ricepanda69/VR-Gloves/Media/IMG_1518.jpg

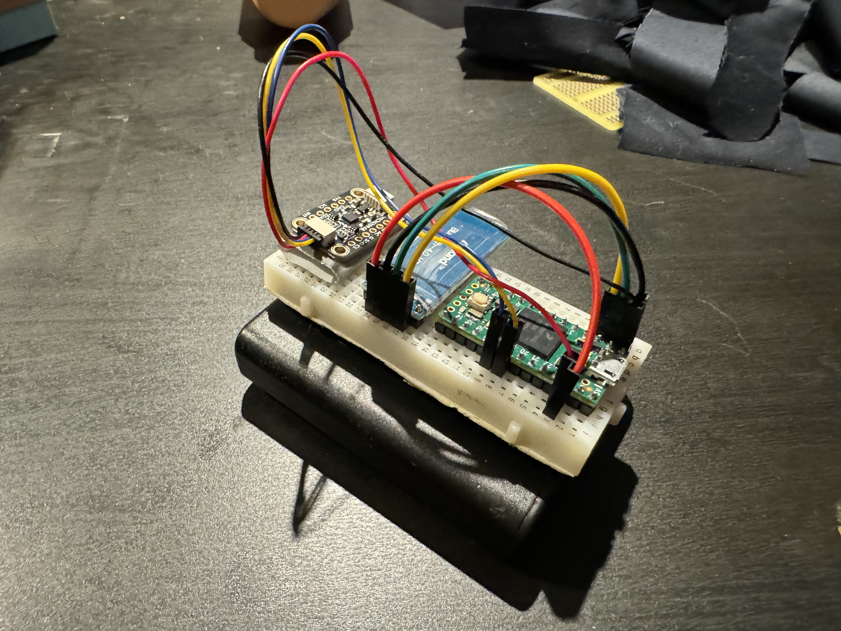
Media/IMG_1518.jpg
