ricepanda69/VR-Gloves/Media/IMG_1519.jpg

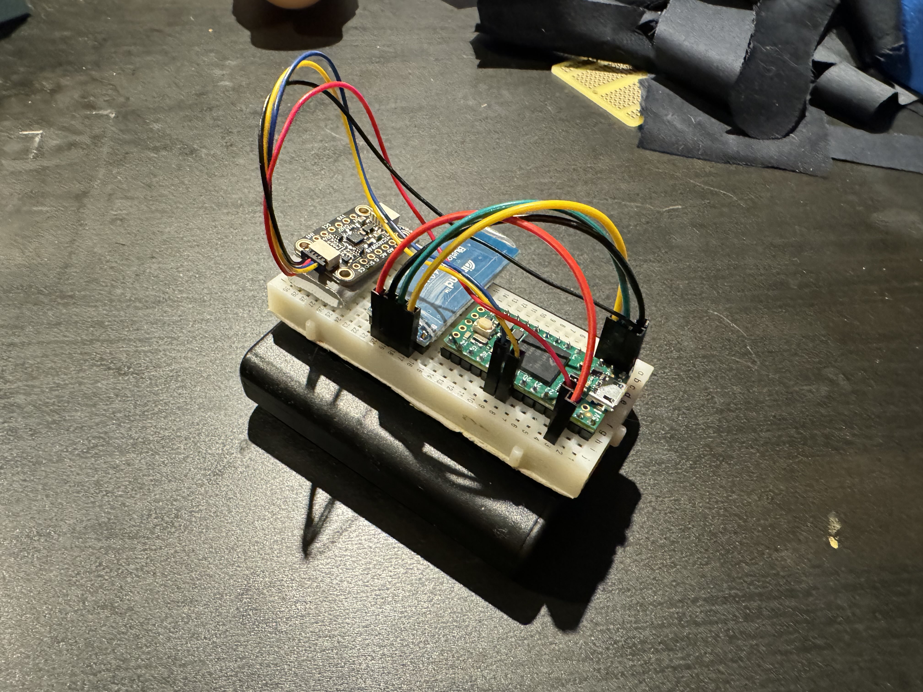
Media/IMG_1519.jpg
