ricepanda69/VR-Gloves/Media/IMG_1520.jpg

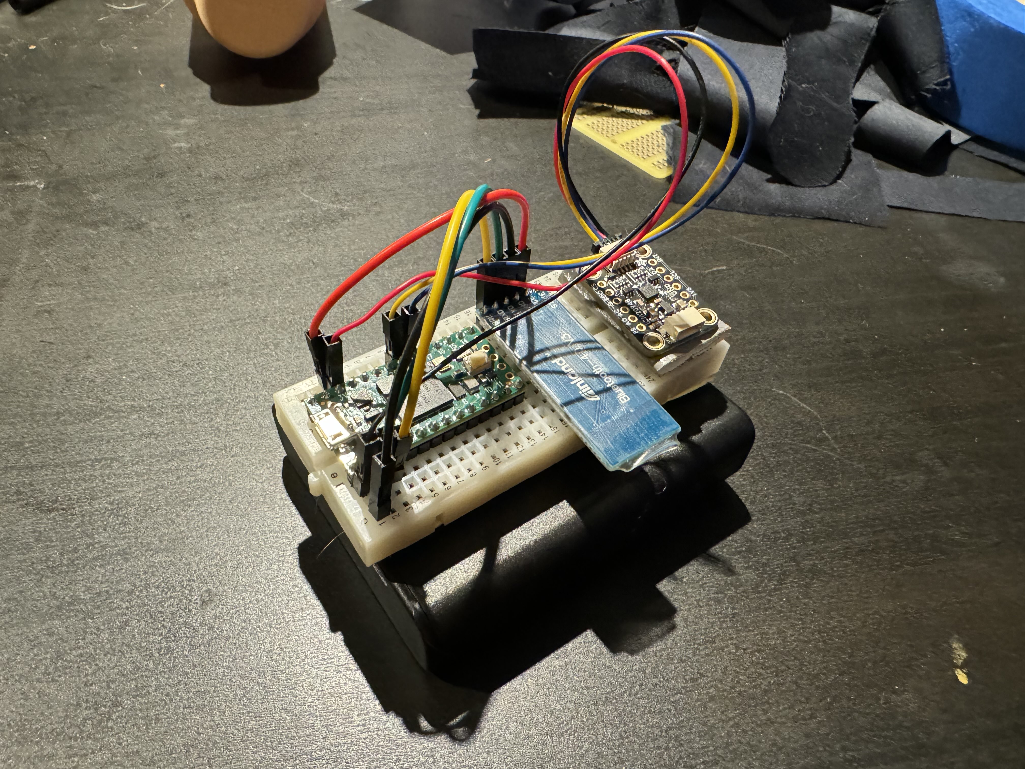
Media/IMG_1520.jpg
