ricepanda69/VR-Gloves/Media/IMG_1521.jpg

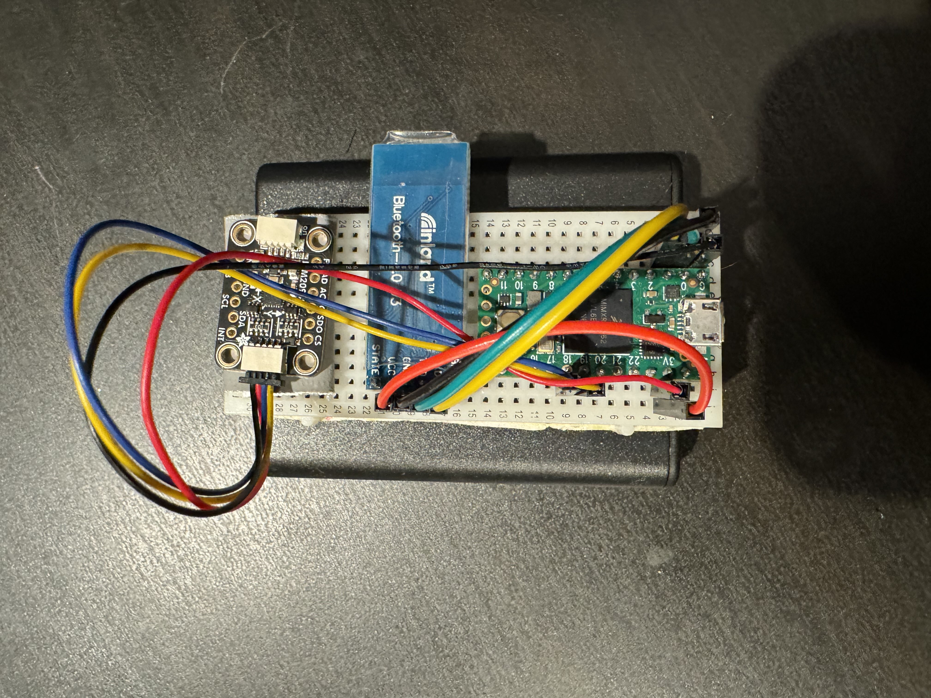
Media/IMG_1521.jpg
