ricepanda69/VR-Gloves/Media/IMG_1522.jpg

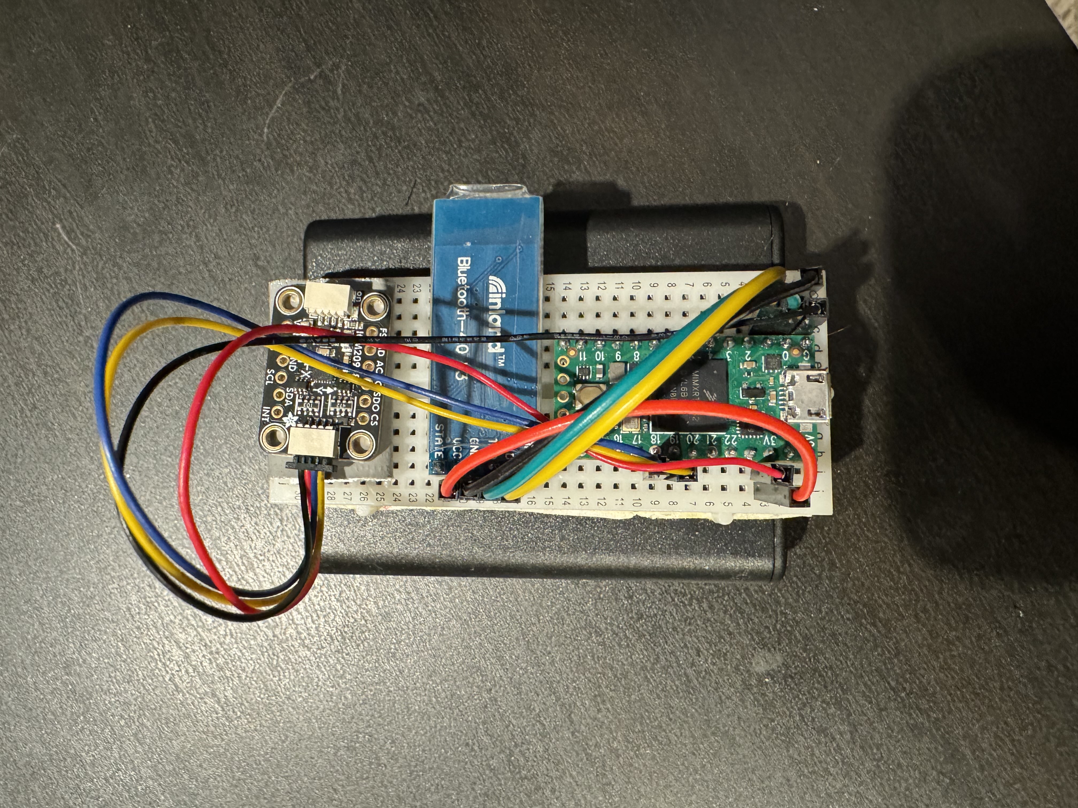
Media/IMG_1522.jpg
