ricepanda69/VR-Gloves/Media/IMG_1523.jpg

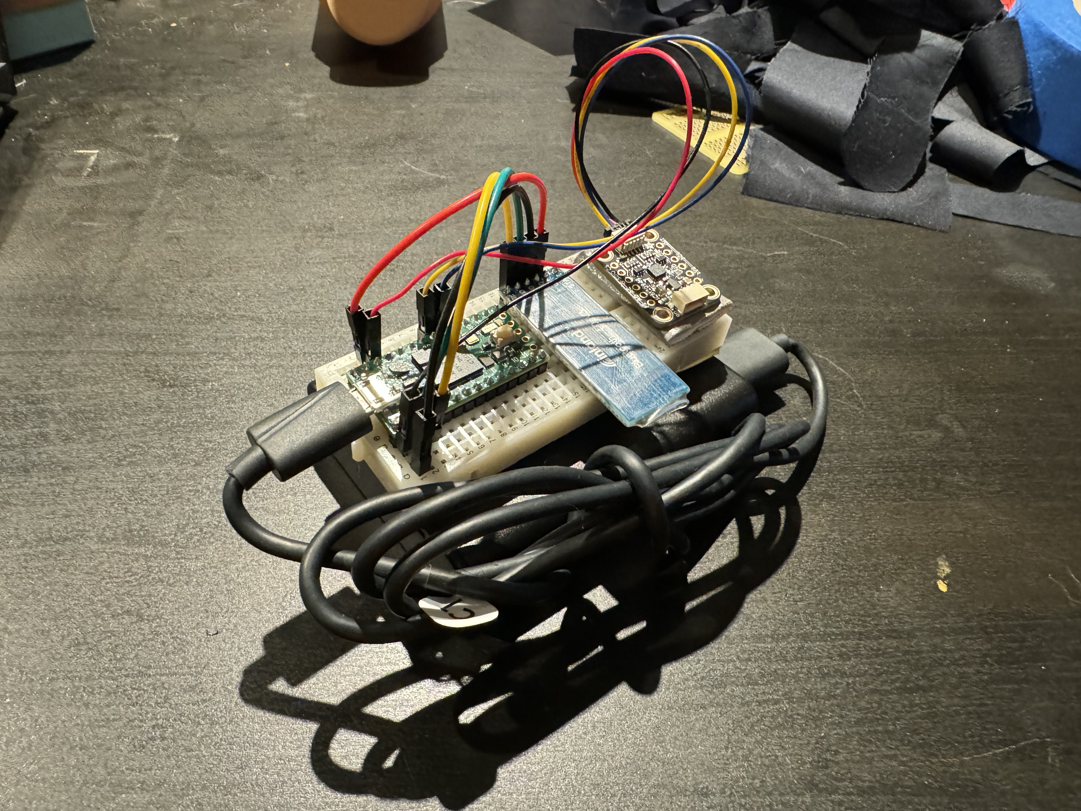
Media/IMG_1523.jpg
