ricepanda69/VR-Gloves/Media/IMG_1524.jpg

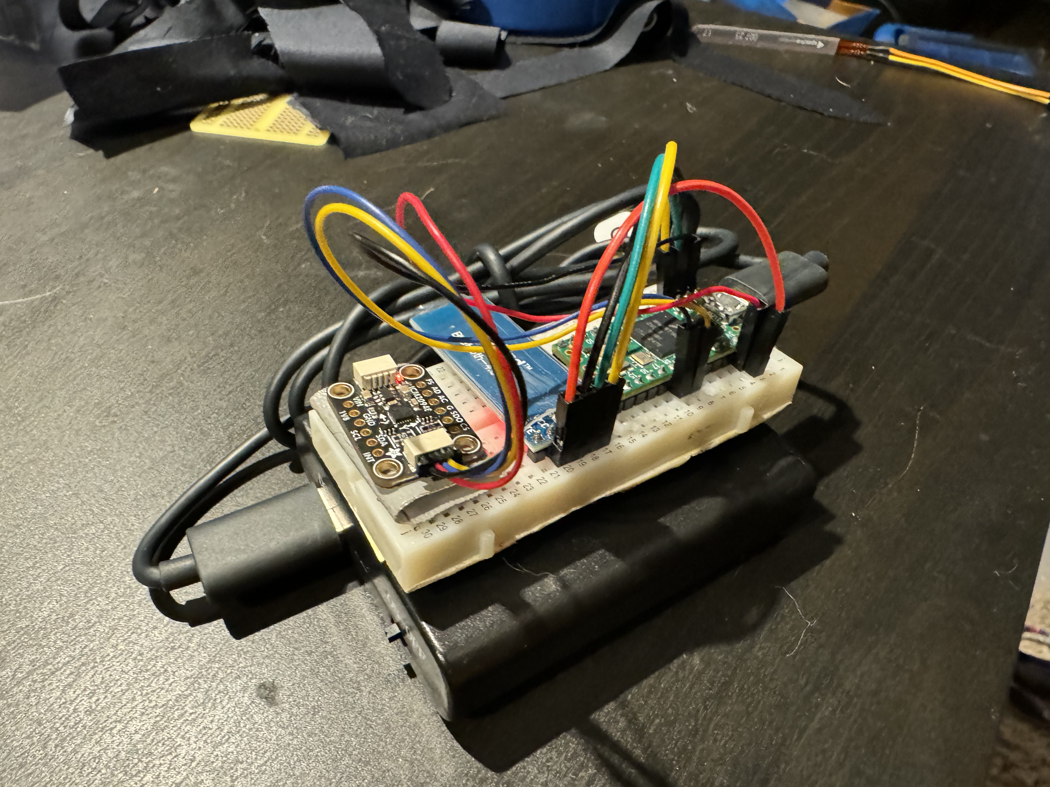
Media/IMG_1524.jpg
