ricepanda69/VR-Gloves/Media/IMG_1525.jpg

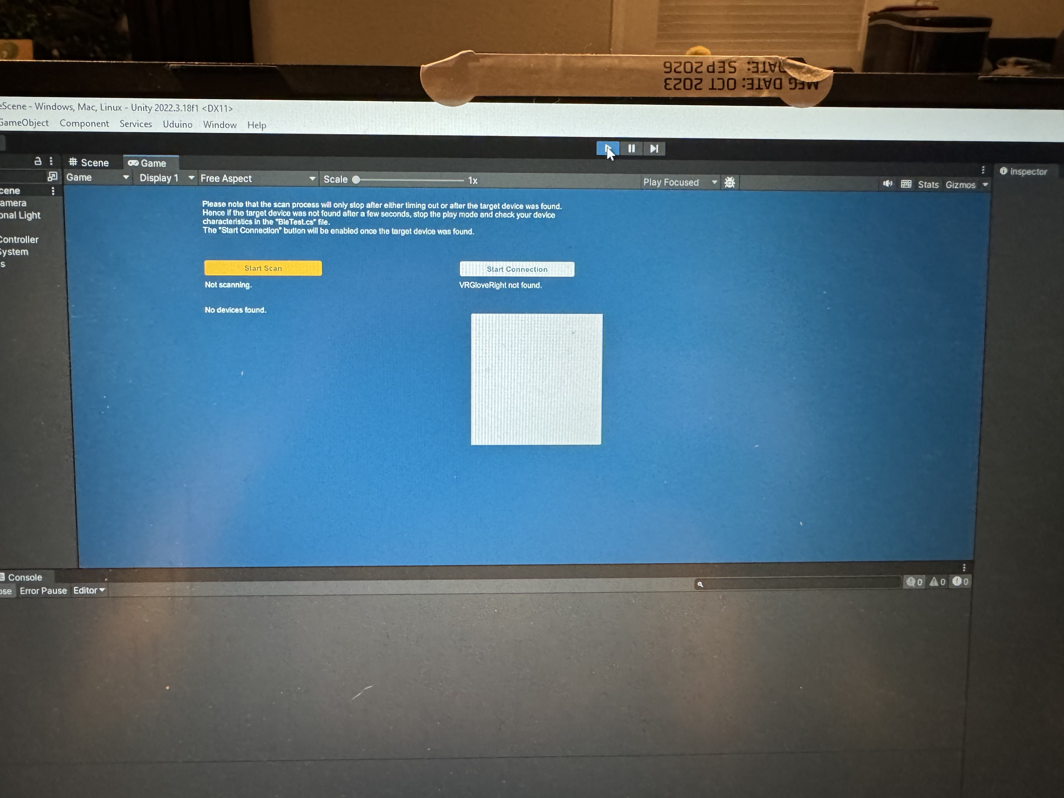
Media/IMG_1525.jpg
