ricepanda69/VR-Gloves/Media/IMG_1527.jpg

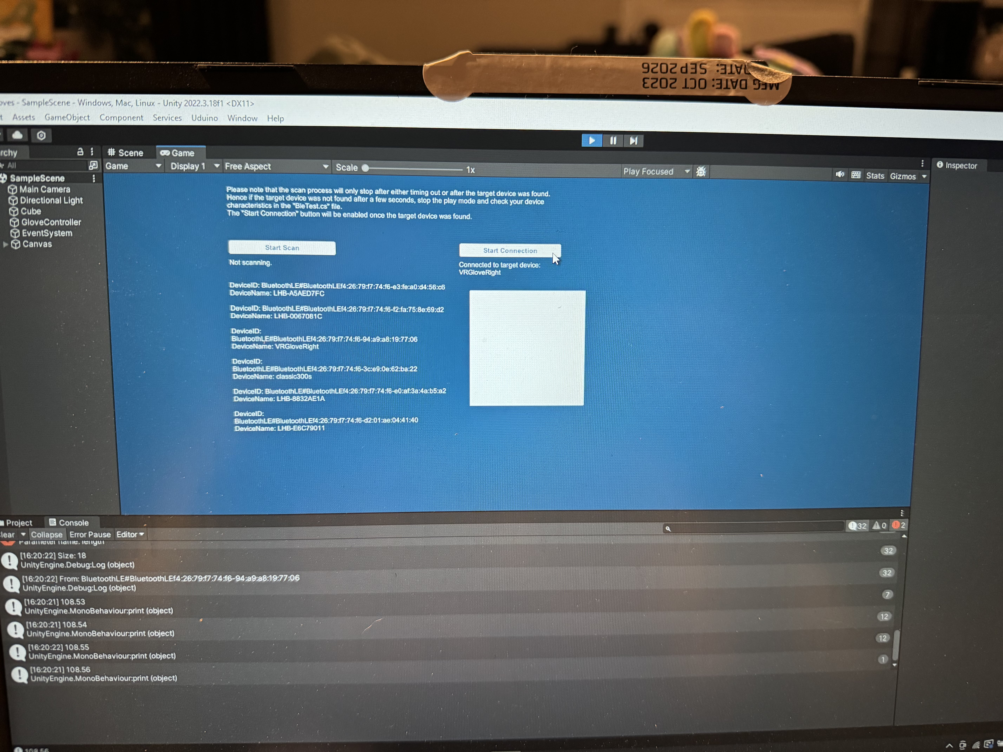
Media/IMG_1527.jpg
