ricepanda69/VR-Gloves/Media/IMG_1555.jpg

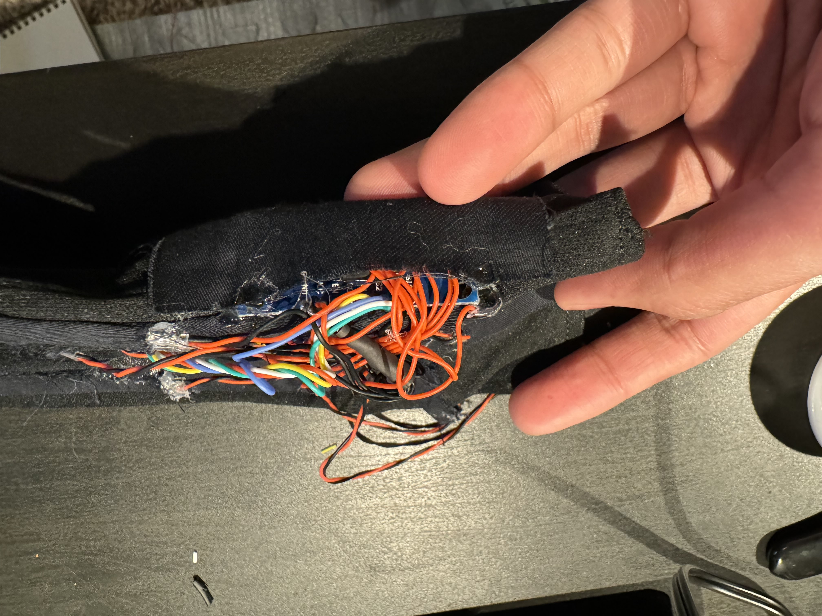
Media/IMG_1555.jpg
