ricepanda69/VR-Gloves/Media/prototype1.png

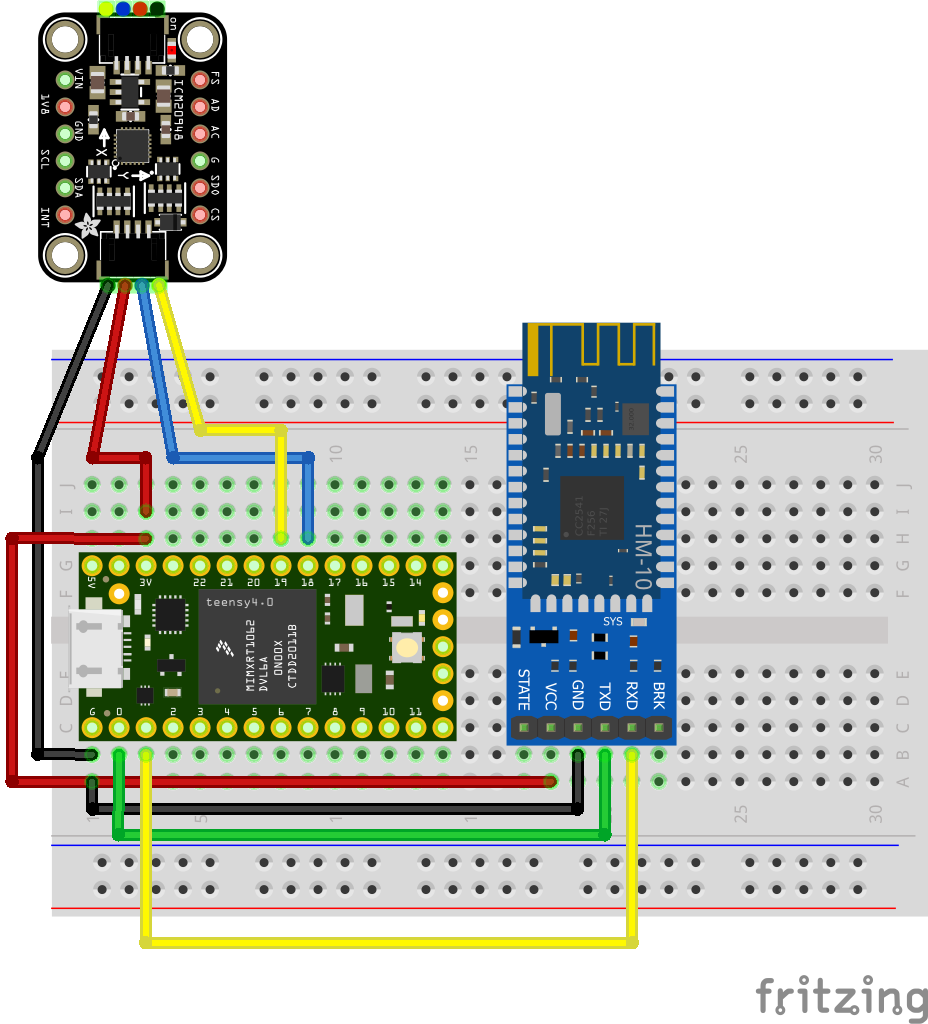
Media/prototype1.png
