ricepanda69/VR-Gloves/Media/prototype2.png

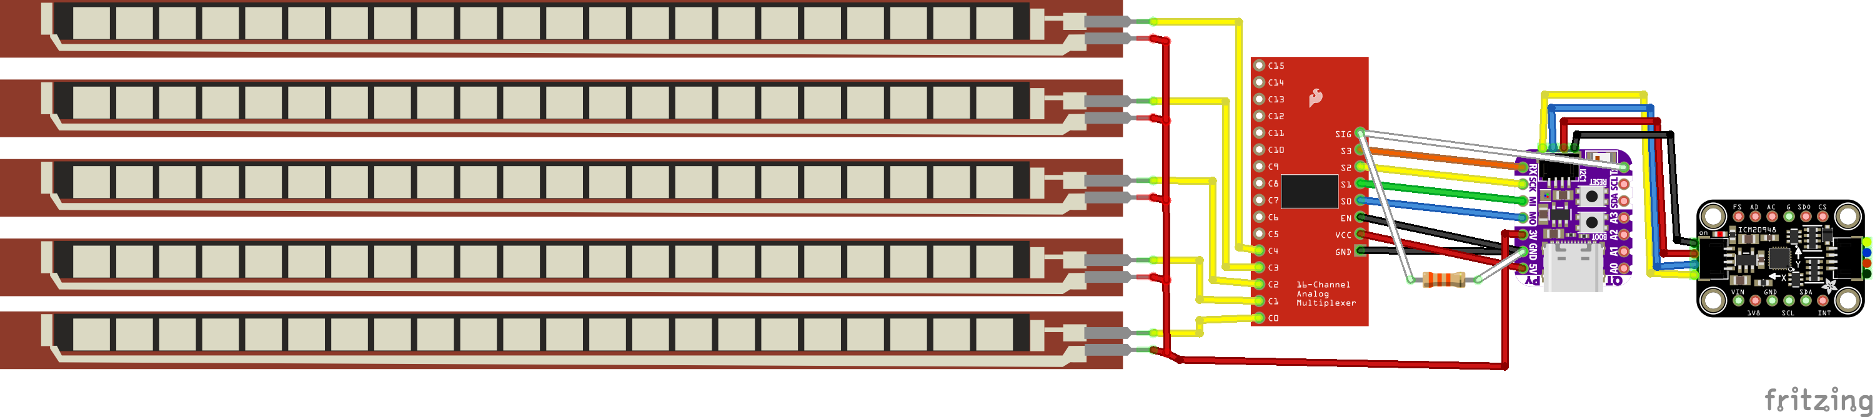
Media/prototype2.png
