ricepanda69/VR-Gloves/Arduino/prototype/prototype.ino

// Full orientation sensing using NXP/Madgwick/Mahony and a range of 9-DoF
// sensor sets.
// You *must* perform a magnetic calibration before this code will work.
//
// To view this data, use the Arduino Serial Monitor to watch the
// scrolling angles, or run the OrientationVisualiser example in Processing.
// Based on  https://github.com/PaulStoffregen/NXPMotionSense with adjustments
// to Adafruit Unified Sensor interface

#include <Adafruit_Sensor_Calibration.h>
#include <Adafruit_AHRS.h>

Adafruit_Sensor *accelerometer, *gyroscope, *magnetometer;

// uncomment one combo 9-DoF!
#include "ICM20948.h"
//#include "LSM6DS_LIS3MDL.h"  // can adjust to LSM6DS33, LSM6DS3U, LSM6DSOX...
//#include "LSM9DS.h"           // LSM9DS1 or LSM9DS0
//#include "NXP_FXOS_FXAS.h"  // NXP 9-DoF breakout

// pick your filter! slower == better quality output
Adafruit_NXPSensorFusion filter; // slowest
//Adafruit_Madgwick filter;  // faster than NXP
//Adafruit_Mahony filter;  // fastest/smalleset

#if defined(ADAFRUIT_SENSOR_CALIBRATION_USE_EEPROM)
  Adafruit_Sensor_Calibration_EEPROM cal;
#else
  Adafruit_Sensor_Calibration_SDFat cal;
#endif

#define FILTER_UPDATE_RATE_HZ 100
#define PRINT_EVERY_N_UPDATES 1

uint32_t timestamp;

void setup() {
  Serial.begin(115200);
  Serial1.begin(115200);

  if (!cal.begin()) {
    Serial.println("Failed to initialize calibration helper");
  } else if (! cal.loadCalibration()) {
    Serial.println("No calibration loaded/found");
  }

  if (!init_sensors()) {
    Serial.println("Failed to find sensors");
    while (1) delay(10);
  }
  
  accelerometer->printSensorDetails();
  gyroscope->printSensorDetails();
  magnetometer->printSensorDetails();

  setup_sensors();
  filter.begin(FILTER_UPDATE_RATE_HZ);
  timestamp = millis();

  Wire.setClock(400000); // 400KHz
}


void loop() {
  float roll, pitch, heading;
  float gx, gy, gz;
  static uint8_t counter = 0;

  if ((millis() - timestamp) < (1000 / FILTER_UPDATE_RATE_HZ)) {
    return;
  }
  timestamp = millis();
  // Read the motion sensors
  sensors_event_t accel, gyro, mag;
  accelerometer->getEvent(&accel);
  gyroscope->getEvent(&gyro);
  magnetometer->getEvent(&mag);

  cal.calibrate(mag);
  cal.calibrate(accel);
  cal.calibrate(gyro);
  // Gyroscope needs to be converted from Rad/s to Degree/s
  // the rest are not unit-important
  gx = gyro.gyro.x * SENSORS_RADS_TO_DPS;
  gy = gyro.gyro.y * SENSORS_RADS_TO_DPS;
  gz = gyro.gyro.z * SENSORS_RADS_TO_DPS;

  // Update the SensorFusion filter
  filter.update(gx, gy, gz, 
                accel.acceleration.x, accel.acceleration.y, accel.acceleration.z, 
                mag.magnetic.x, mag.magnetic.y, mag.magnetic.z);

  // only print the calculated output once in a while
  if (counter++ <= PRINT_EVERY_N_UPDATES) {
    return;
  }
  // reset the counter
  counter = 0;

  // print the heading, pitch and roll
  roll = filter.getRoll();
  pitch = filter.getPitch();
  heading = filter.getYaw();
  
  char msg[20] = "0123456789ABCDEF\r\n";
  sprintf(msg, "%.02f,%.02f,%.02f,", roll, pitch, heading);
  Serial1.print(msg);
  Serial1.flush();
}
